thorthefish/Small-croxy/pictures/IMG_4490.jpeg

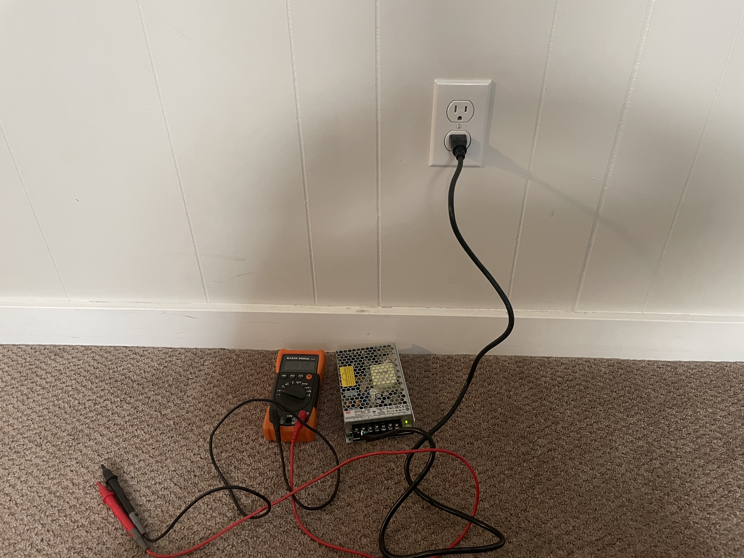
pictures/IMG_4490.jpeg
