thorthefish/Small-croxy/pictures/IMG_4537.jpeg

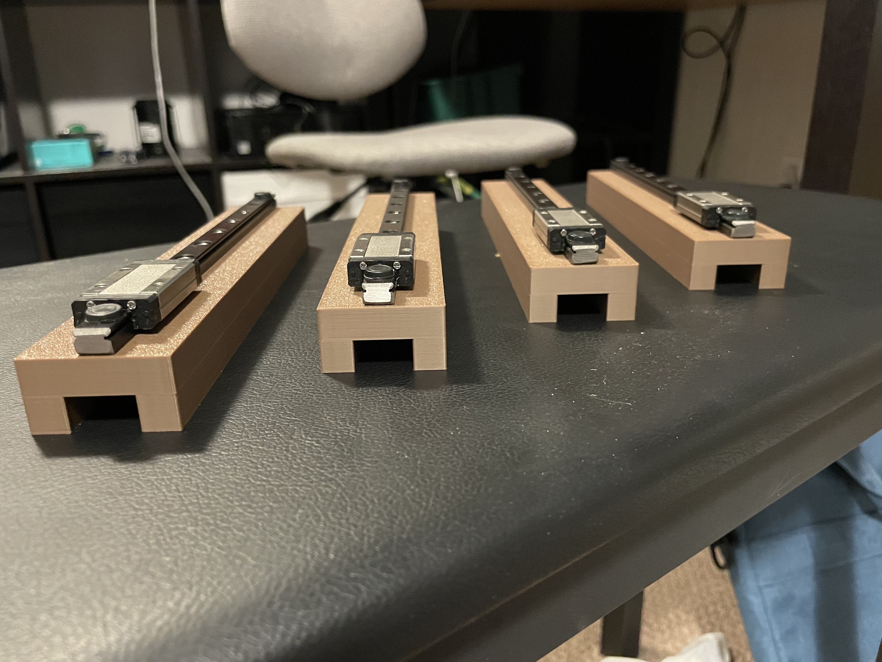
pictures/IMG_4537.jpeg
