thorthefish/Small-croxy/README.md

# Smol-croxy

This project is a cross gantry 3d printer, that uses a mostly 3d printed frame. It is a very useful tool for prototyping, due to its low cost compared to other costom 3d printers, especialy other cross gantry design, which are usualy $1200 minimum. Another fun part about it is the insane acceleration and speeds that are accesable through the dual motors and direct drive system.

# Why

I decided to build and design this particular project because of the hypercube overkill project on Reprap https://reprap.org/forum/read.php?177,807843, and after I saw the forum post for the first time about a year ago, I havnt been able to get it out of my head. I love the benefits of cross gantry designs and they are one of the fastest possible kinematic syatems of printers, but due to their cost,I have never been able to consider building one, so I decided to make a cross gantry design for as little as possible to prove that the high pricetag was not nesicary to get into this particular design.

Also I just wanted a  fun first printer project.

# CAD







# BOM

|Bill of Materials| | |
|---|-|-|
||||
|Motion| | |
||||
|GT2 6mm wide Belt 4 meters	| free |	Use old stuff i have|
|4 - 20 Tooth 5mm Bore Pulley |	$7.00	|https://s.click.aliexpress.com/e/_DmbhjDN|
|4 - 20 Tooth 5mm Bore idler |	free	| 3dp |
|6 - Gantry mgn 9 200mm	| $66.00	|https://www.robotdigg.com/product/1314/Black-anodized-linear-rail-7,-9,-12-and-15|
|4 - 8mm Linear Rod 200mm length	| $25.00	|https://www.aliexpress.us/item/2255800086494873.html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|
|5 - Nema 17 Steppers	| $46.00	|https://www.omc-stepperonline.com/nema-17-bipolar-59ncm-84oz-in-2a-42x48mm-4-wires-w-1m-cable-connector-17hs19-2004s1|
|Lead Screw 8 mm lead 200mm	| $6.00	|https://www.aliexpress.us/item/3256803126209223.html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|
|Linear Bearings (igus design)	| $8.00	|https://www.aliexpress.us/item/3256806998378536.html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|
|Lead screw to stepper addapter|	free	| 3dp |
|4pcs 2020 extrusion 200mm | $13 | https://www.amazon.com/Tsnamay-Aluminum-Extrusion-European-Standard/dp/B0C432TBNK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|
||||	
|Hardware| | |	
||||
|m3 x 20mm	| $7.00	|https://www.amazon.com/Socket-Screw-Thread-stainless-100pcs/dp/B078CXM81F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|
|m3 x 30mm + Nuts and Washers	| $9.00	|https://www.amazon.com/Bemaka-550PCS-Washers-Assortment-Stainless/dp/B0D5CSSYGH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
|m3 x 15mm(chop down 20mm)	| $7.00	|https://www.amazon.com/Socket-Screw-Thread-stainless-100pcs/dp/B078CXM81F?|crid=SVZ6ZVO9CH88&dib=eyJ2IjoiMSJ9.q6E9NIbUqM2ZUEv1RWL1WRtvKj3SNLDo2R1ZT8rj0JjJymfK7DlziPyPhQ9RmYXqtFsmmF5RfL8V4i02E_YMdOe8PfafsIYf-f2_rEaEErhMN4e815gjUTRqY2QU83KdpUdh8nADbf6dZQZNQqsK2pDqByec_Kuya0WOqCijrjozfrKOcGIRmeSK5eXGzWMCCAY-3pPW9X5ySbmHxO28B7zKEQrdl4dj_4N4csIqrsQ.U1aUu0Slo90zMGR9u3oTCXOrKLJl8OYB_KGRmXcT-MM&dib_tag=se&keywords=m3%2B20mm&qid=1749000859&sprefix=m3%2B20mm%2Caps%2C140&sr=8-3&th=1|
|Heatset Inserts	| $8.00	|https://www.aliexpress.us/item/2255800046543591.html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|
|bearings 5x14	| $8.00	|https://www.amazon.com/HiPicco-605-2RS-Bearings-Miniature-Pre-Lubricated/dp/B0CH2X65Y6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|
||||	
|Extruder + Hotend| | |
||||
|Trianglelab v6 all metal hotend	| $15.00	|https://trianglelab.net/products/v6-all-metal-hotend?VariantsId=10012|
|BMG clone cxtruder	| $6.00	|https://www.aliexpress.us/item/3256805805447850.html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|
|Pankake stepper for extruder	| $5.00	|https://www.omc-stepperonline.com/e-series-nema-17-bipolar-1-8deg-17ncm-24-07oz-in-1a-42x42x23mm-4-wires-17he08-1004s|
|PTFE tube	| $2.00	|https://www.aliexpress.us/item/3256801260455800.html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|
||||	
|BED| | |
||||
|Buildplate	| $16.00	|https://www.aliexpress.us/item/3256808481230553.html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|
|100 x 100mm Heater	| $11.00	|https://s.click.aliexpress.com/e/_DdKRBD1|
|Bed Springs and M3 Bolts	| $4.00	|https://s.click.aliexpress.com/e/_DFBWBZP|
||||		
|Electronics| | |
||||
|Power supply - Mean Well |	$29	|https://www.digikey.com/en/products/detail/mean-well-usa-inc/LRS-150-24/7705015|
|klipper laptop (instead of pi)	| freeeeee	|old vaio|
|btt spyder	| $40	|https://www.aliexpress.us/item/3256802425339653.html?gatewayAdapt=glo2usa4itemAdapt|
|4010 fans	| $6	|https://www.aliexpress.us/item/2251832626712781.html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|
|5015 fans	| $8	|https://www.aliexpress.us/item/3256804896091521.html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|
|limit switches	| $3	|https://www.aliexpress.us/item/3256801412797483.html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,scm-url:1007.14452.396806.0,pvid:b97728e4-87ac-45ef-88c4-bf1cdbf0d7cc,tpp_buckets:668%232846%238114%231999&pdp_ext_f=%7B%22order%22%3A%22441%22%2C%22eval%22%3A%221%22%2C%22sceneId%22%3A%2230050%22%7D&pdp_npi=4%40dis%21USD%212.93%212.55%21%21%212.93%212.55%21%402101c5ac17490034128137397e69ea%2112000047027348662%21rec%21US%21%21ABXZ&utparam-url=scene%3ApcDetailTopMoreOtherSeller%7Cquery_from%3A&search_p4p_id=202506031916528631335802323094798288_0|
||||
|TOTAL USD	| $342.00| |
