thorthefish/Small-croxy/pictures/IMG_4502.jpeg

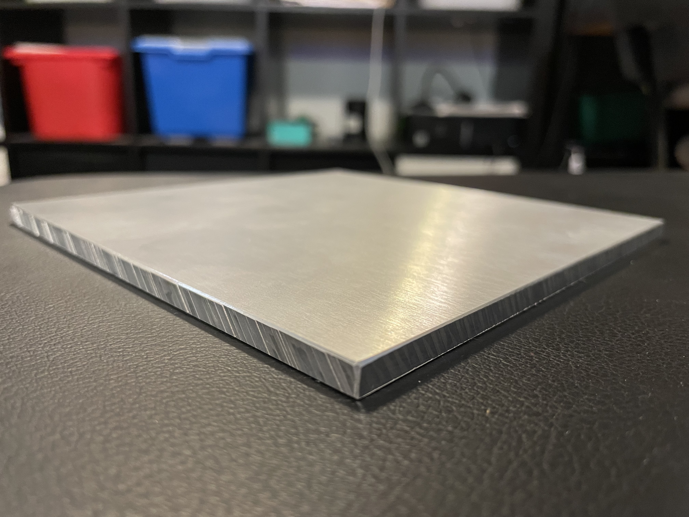
pictures/IMG_4502.jpeg
