thorthefish/Small-croxy/pictures/IMG_4534.jpeg

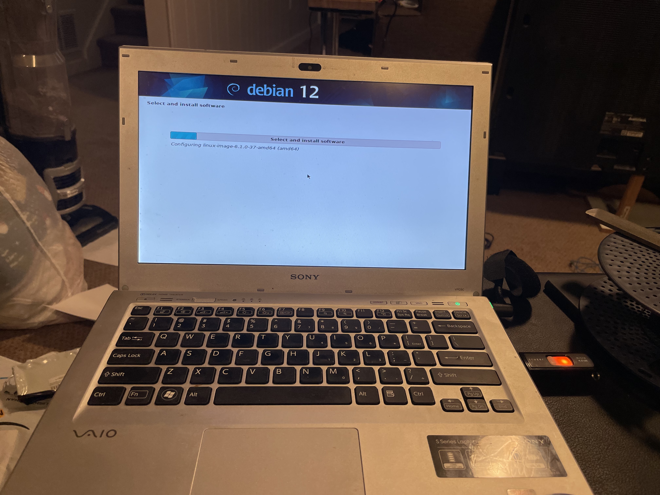
pictures/IMG_4534.jpeg
