thorthefish/Small-croxy/pictures/IMG_4535.jpeg

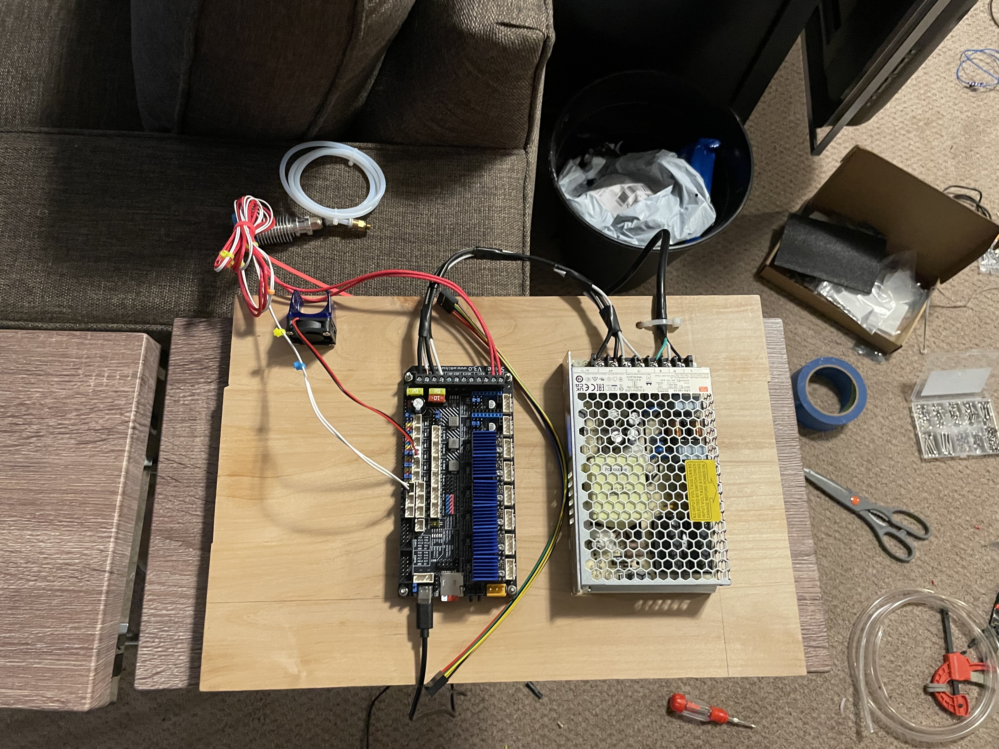
pictures/IMG_4535.jpeg
