thorthefish/Small-croxy/pictures/IMG_4538.jpeg

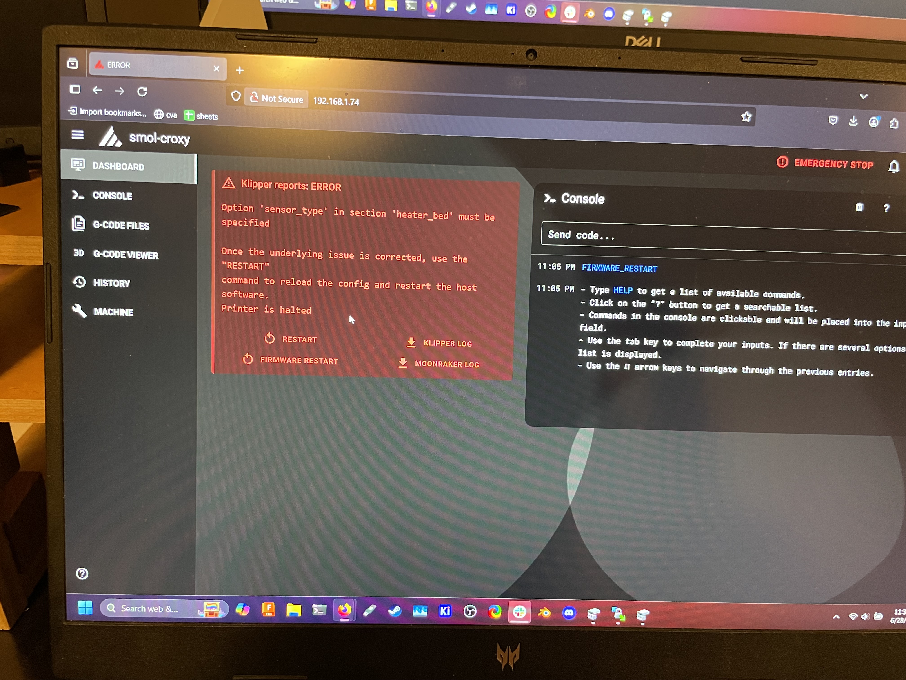
pictures/IMG_4538.jpeg
