thorthefish/Small-croxy/pictures/IMG_4539.jpeg

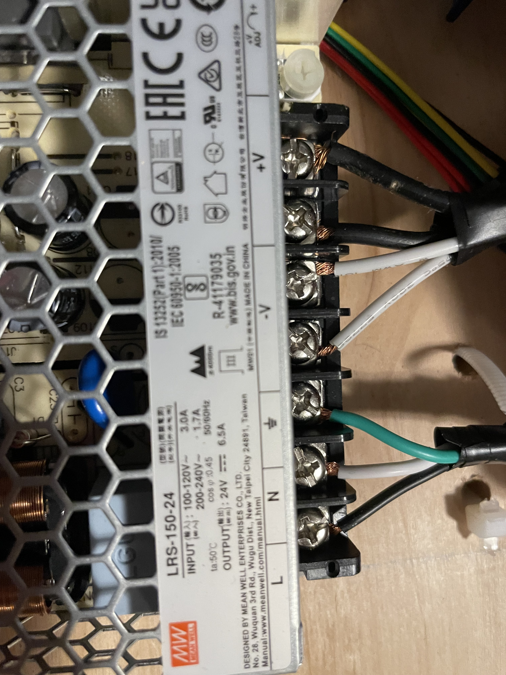
pictures/IMG_4539.jpeg
