thorthefish/Small-croxy/Small Croxy BOM V2.csv

Smol Croxy | Price | Source |  | Alt
Frame
*ALL PRICES ROUNDED UP, BUT SHIPPING NOT FACTORED
Motion
GT2 6mm wide Belt 4 meters | free | Use old stuff i have
4 - 20 Tooth 5mm Bore Pulley | $7.00 | https://s.click.aliexpress.com/e/_DmbhjDN | y
4 - 20 Tooth 5mm Bore idler | $9.00 | https://www.amazon.com/WINSINN-Aluminum-Timing-Pulley-Printer/dp/B07BPGYX3G | y
6 - Gantry mgn 9 200mm | $60.00 | https://www.amazon.com/ONLISUM-Bearing-Sliding-Carriage-Printer/dp/B0D5MDYRQG?gQT=2&th=1 | y
2 - 8mm Linear Rod 200mm length | $10.00 | https://www.aliexpress.us/item/3256807678401272.html?
6pcs, 2x - Nema 17 Steppers | $64.00 | https://www.aliexpress.us/item/3256808836527298.html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 | y
Lead Screw 8 mm lead 200mm | $4.00 | https://www.aliexpress.us/item/3256807271104483.html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 | y
Linear Bearings | $3.00 | https://www.aliexpress.us/item/3256806883965670.html?gatewayAdapt=glo2usa | y
Lead screw to stepper addapter | 3dp
4pcs 2020 extrusion 200mm | $12.00 | https://www.amazon.com/Tsnamay-Aluminum-Extrusion-European-Standard/dp/B0C432TBNK | y
Hardware
m3 x 20mm | $7.00 | https://www.amazon.com/Socket-Screw-Thread-stainless-100pcs/dp/B078CXM81F | y
m3 x 30mm + Nuts and Washers | $9.00 | https://www.amazon.com/Bemaka-550PCS-Washers-Assortment-Stainless/dp/B0D5CSSYGH | y
Heatset Inserts | $3.00 | https://www.aliexpress.us/item/3256803396040989.html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 | y
bearings 6x17 mm | $5.00 | https://www.aliexpress.us/item/3256806840177845.html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 | y
Extruder + Hotend
Bambu clone hotend | $7.00 | https://www.aliexpress.us/item/3256808727224396.html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 | y
BMG clone extruder | $6.00 | https://www.aliexpress.us/item/3256805805447850.html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 | y
PTFE tube | $4.00 | https://www.aliexpress.us/item/3256805576880920.html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 | y
bowden connectors | $2.00 | https://www.aliexpress.us/item/3256802731755032.html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 | y
BED
Buildplate | $16.00 | https://www.aliexpress.us/item/3256808481230553.html?src=google&gPromoCode=5000000169902232&gQT=1 | y
Bed Springs and M3 Bolts | $3.00 | https://www.aliexpress.us/item/3256801174082850.html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 | y
Electronics
Power supply - Mean Well | $32 | https://www.digikey.com/en/products/detail/mean-well-usa-inc/LRS-150-24/7705015 | y
klipper laptop (instead of pi) | freeeeee | old vaio
btt spider | $32 | https://www.aliexpress.us/item/3256802425339653.html?gatewayAdapt=glo2usa4itemAdapt | y
6x stepper dirvers | $17 | https://www.aliexpress.us/item/3256805074646808.html?mp=1 | y
Fan Set | $4 | https://www.aliexpress.us/item/3256802661325134.html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 | y
limit switches | $3 | https://www.aliexpress.us/item/3256801412797483.html?scm_id=1007.14452.396806.0&scm-url=1007.14452.396806.0 | y
TOTAL ESTIMATED USD | $319.00 | Amazon: | 122
Subtotal USD | $329.00 | AliExpress | 175
Remaining USD | -$10.00 | Digikey: | 32
 |  | Robotdigg | 0
 |  | Stepper Direct | 0
