thorthefish/Small-croxy/CAD/Assembly 2.step

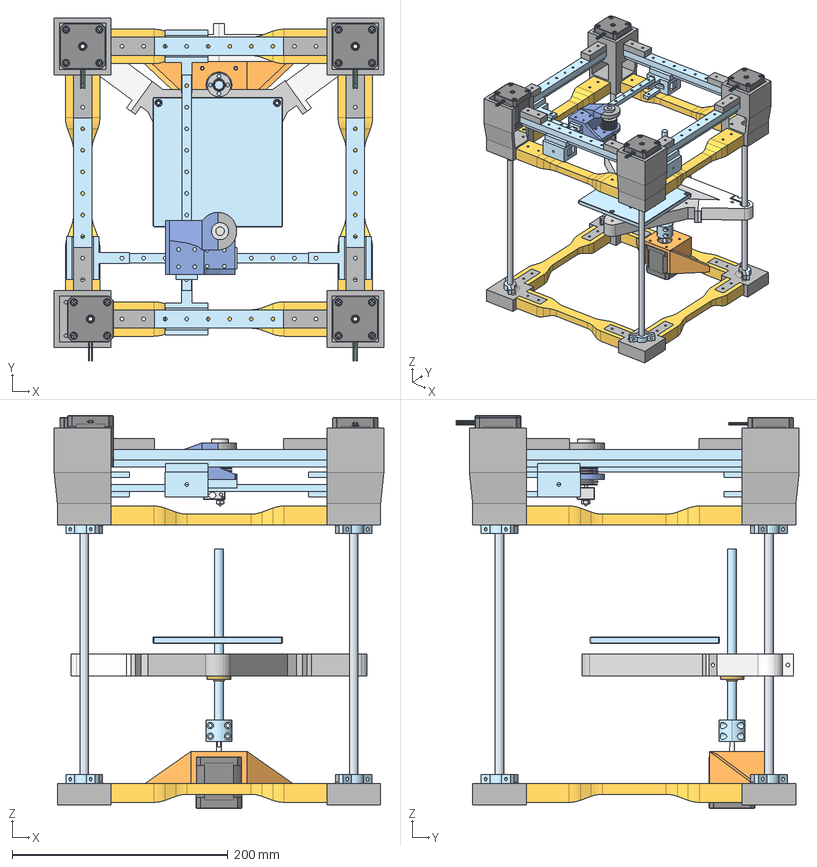
[picture p13: CAD file, 2025-06-04]
CAD/Assembly 2.step
306.0 x 318.7 x 364.7 mm
17HS19-2004S1 x 5
120x120mm MIC6
8mm Lead Screw Nut
E3D V6 1.75mm Universal HotEnd Mockup
