thorthefish/Small-croxy/(commit log)

2025-06-04 Create cad
2025-06-11 Update and rename Smol Croxy BOM -1 - Rook Mk1.csv to Small Croxy BOM V2
2025-06-11 Update and rename Small Croxy BOM V2 to Small Croxy BOM V2.csv
    [Small Croxy BOM V2.csv]
2025-06-11 Update and rename Small Croxy BOM.csv to Old Stuff/Small Croxy BOM.csv
    [Small Croxy BOM.csv]
