thorthefish/Small-croxy/pictures/IMG_4489.jpeg

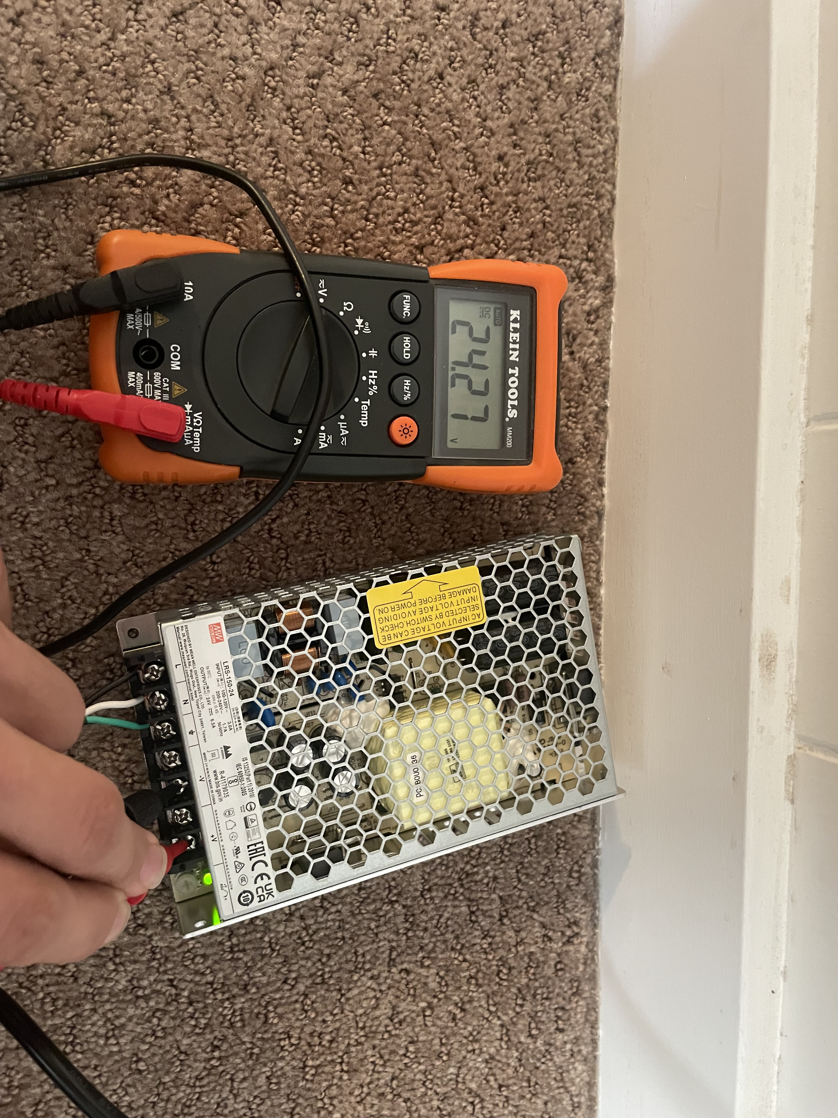
pictures/IMG_4489.jpeg
