thorthefish/Small-croxy/pictures/IMG_4499.jpeg

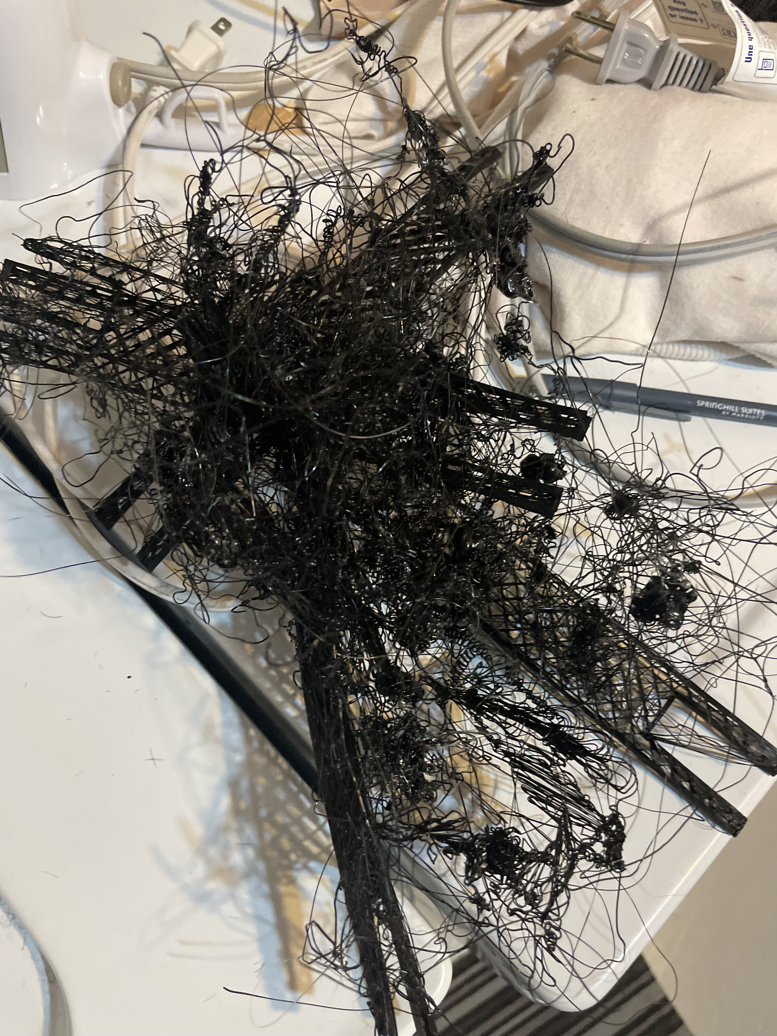
pictures/IMG_4499.jpeg
