thorthefish/Small-croxy/pictures/IMG_4500.jpeg

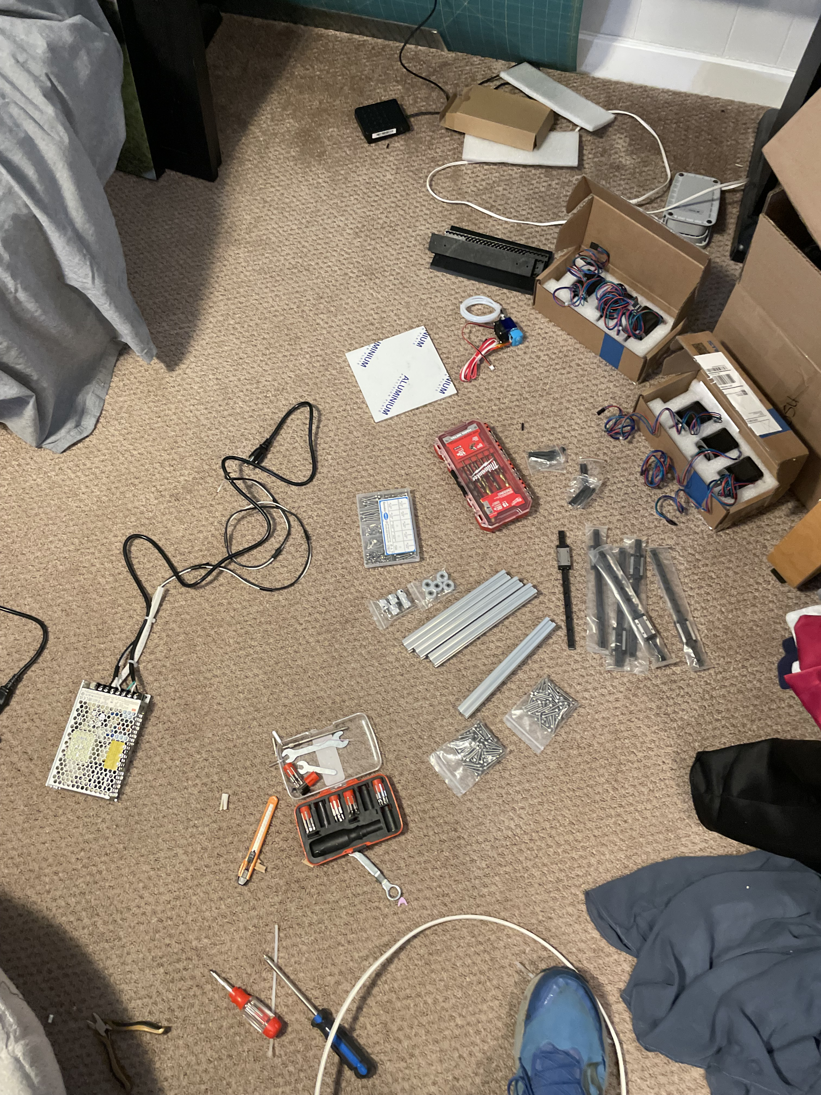
pictures/IMG_4500.jpeg
