thorthefish/Small-croxy/pictures/IMG_4536.jpeg

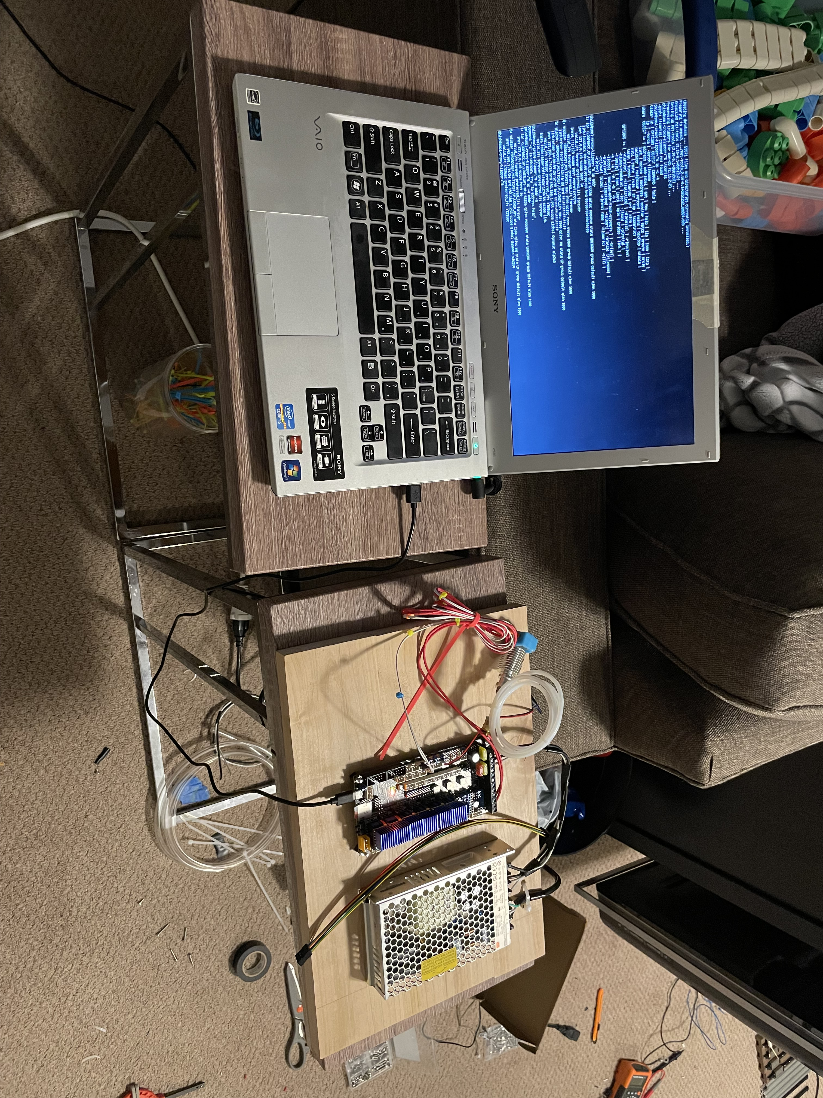
pictures/IMG_4536.jpeg
