thorthefish/Small-croxy/pictures/IMG_4540.jpeg

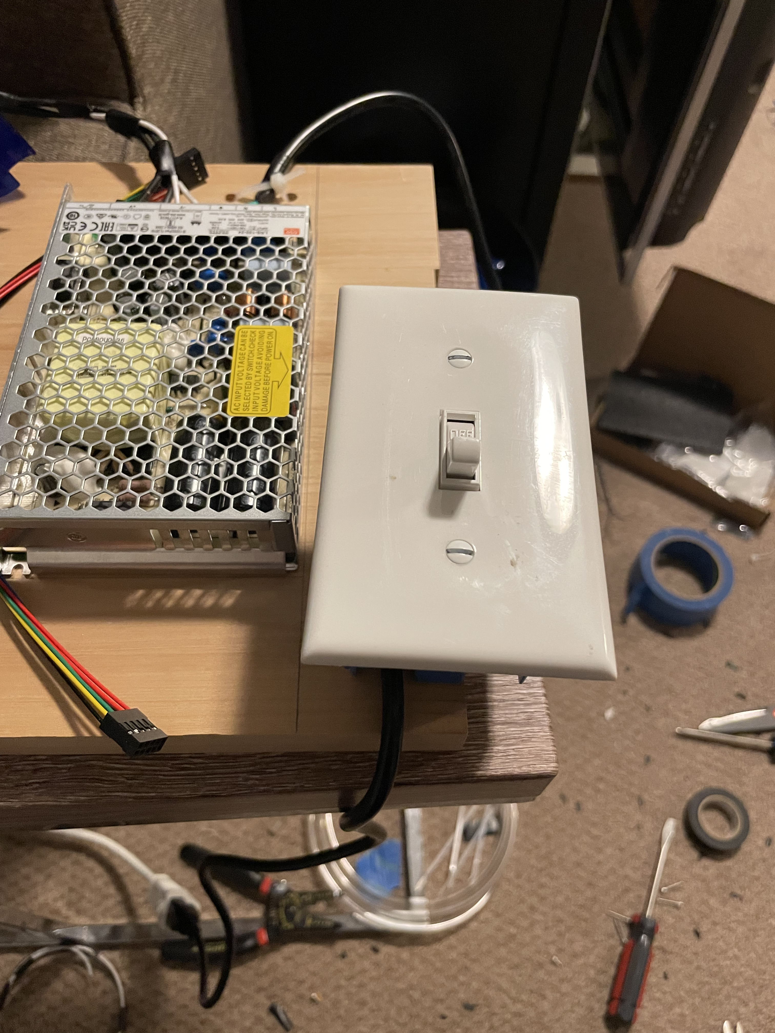
pictures/IMG_4540.jpeg
